tjm-git/ValveSpringTester/pics/Rimac® Valve Spring Tester _ 0 to 1000 lb._ Goodson Tools & Supplies_page2.png

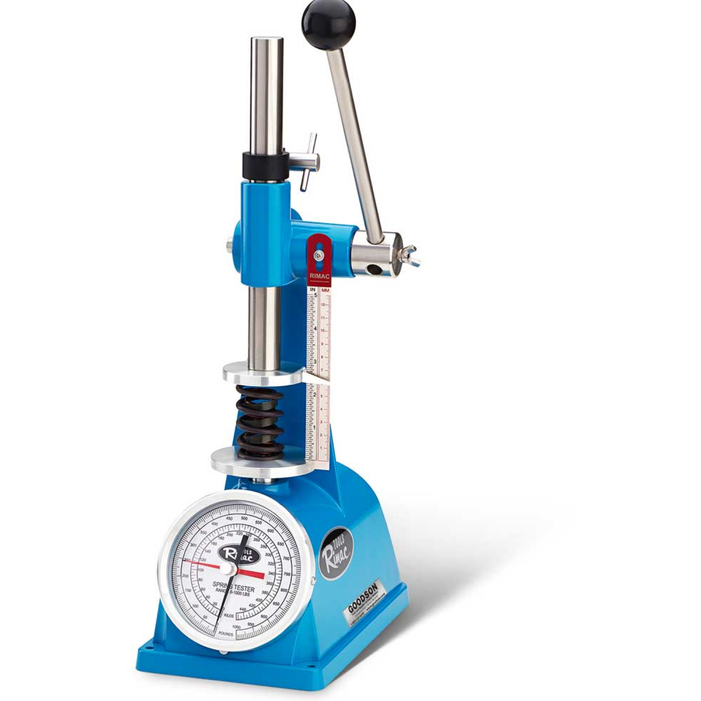
pics/Rimac® Valve Spring Tester _ 0 to 1000 lb._ Goodson Tools & Supplies_page2.png
