tjm-git/ValveSpringTester/pics/EncoderPic.jpg

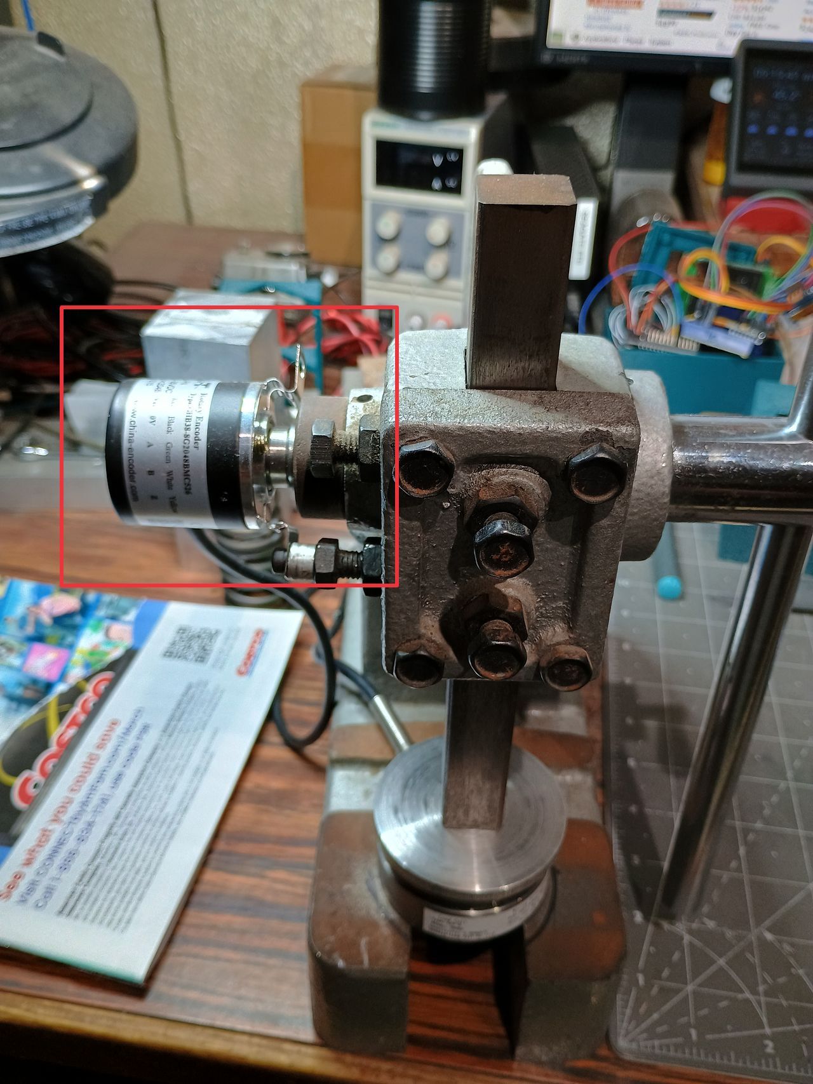
pics/EncoderPic.jpg
